UgoesSky/UgoesSky-V3.0b-PITS-Hardware/Bilder/1.jpg

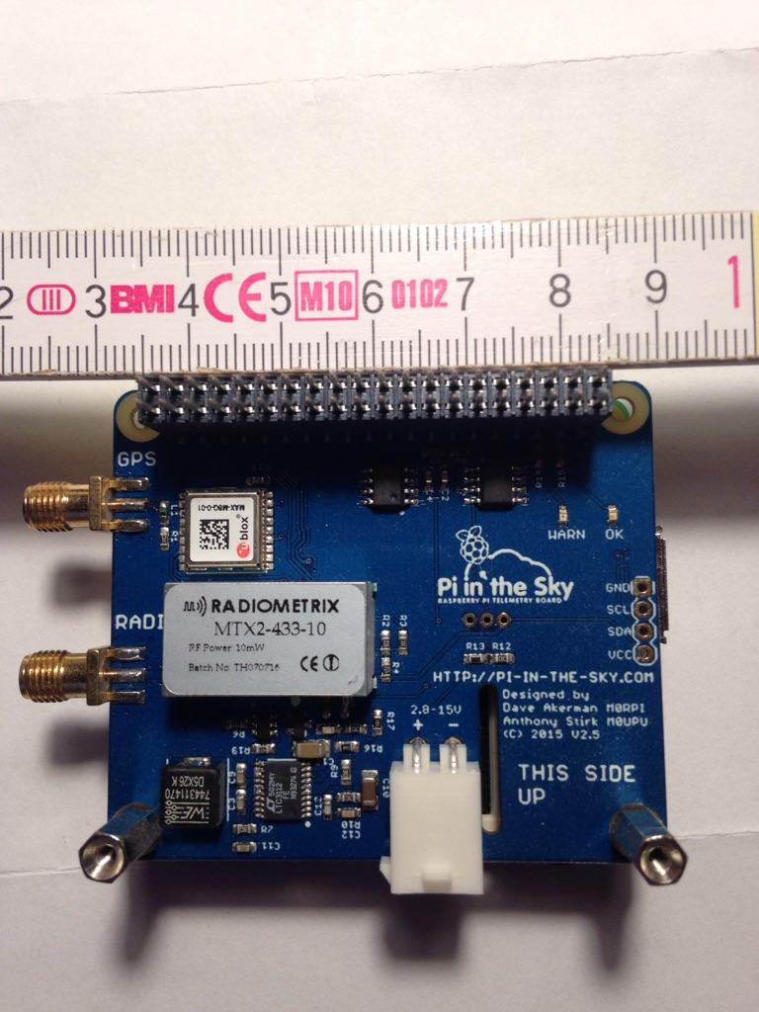
Bilder/1.jpg
