UgoesSky/UgoesSky-V3.0b-PITS-Hardware/Bilder/4.jpg

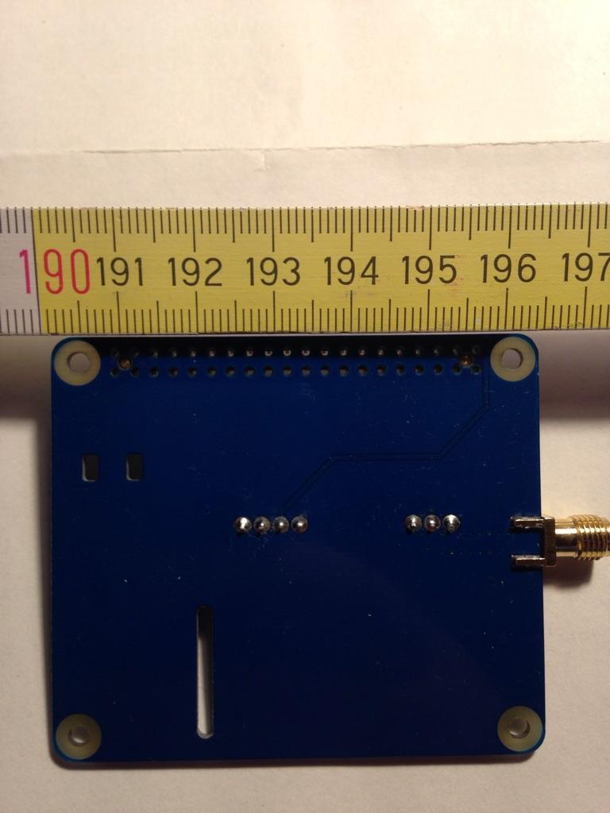
Bilder/4.jpg
