UgoesSky/UgoesSky-V3.0b-PITS-Hardware/README.md

# UgoesSky-V3.0b-PITS-Hardware
https://github.com/PiInTheSky/pits-hardware
