UgoesSky/UgoesSky-V3.0b-PITS-Hardware/Bilder/2.jpg

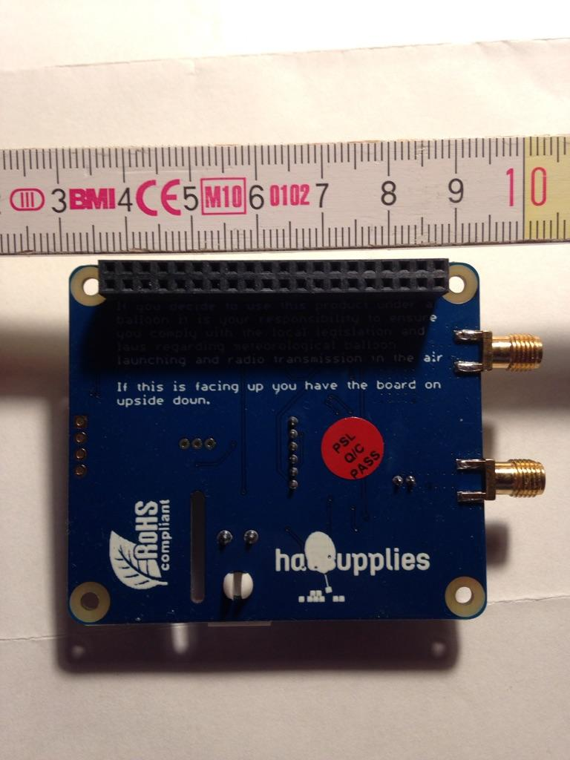
Bilder/2.jpg
