UgoesSky/UgoesSky-V3.0b-PITS-Hardware/Bilder/3.jpg

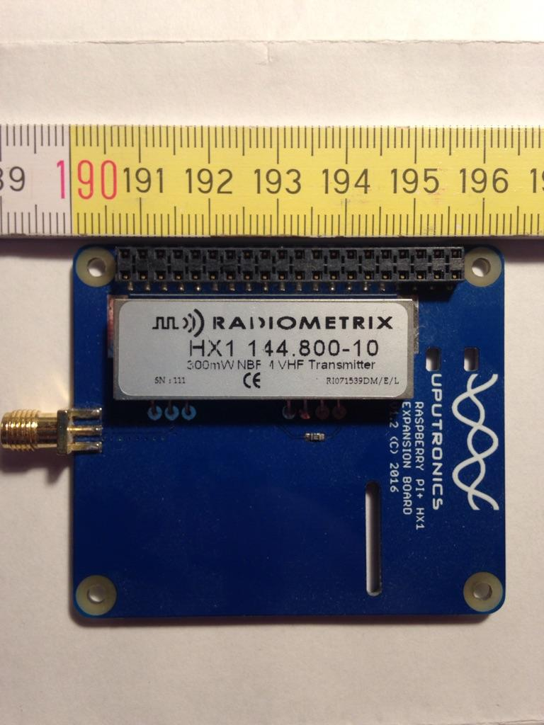
Bilder/3.jpg
