UgoesSky/UgoesSky-V3.0b-PITS-Hardware/Bilder/aprs.jpg

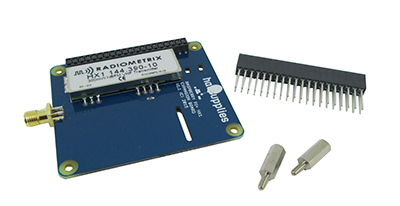
Bilder/aprs.jpg
