UgoesSky/UgoesSky-V3.0b-PITS-Hardware/Bilder/lora.jpg

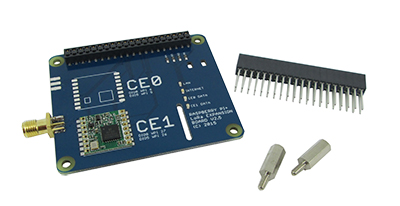
Bilder/lora.jpg
