UgoesSky/UgoesSky-V3.0b-PITS-Hardware/Bilder/mainboard.jpg

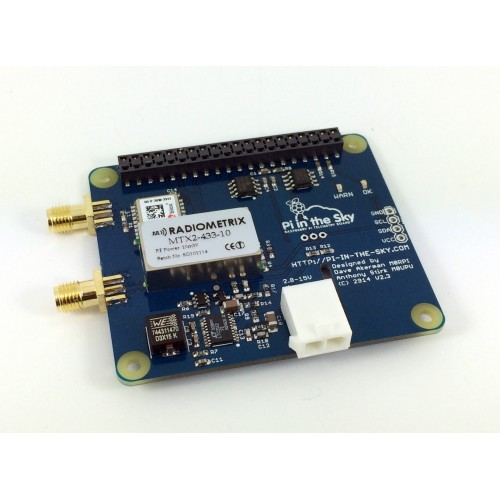
Bilder/mainboard.jpg
