UgoesSky/UgoesSky-V3.0b-PITS-Hardware/Bilder/Matek/1.jpg

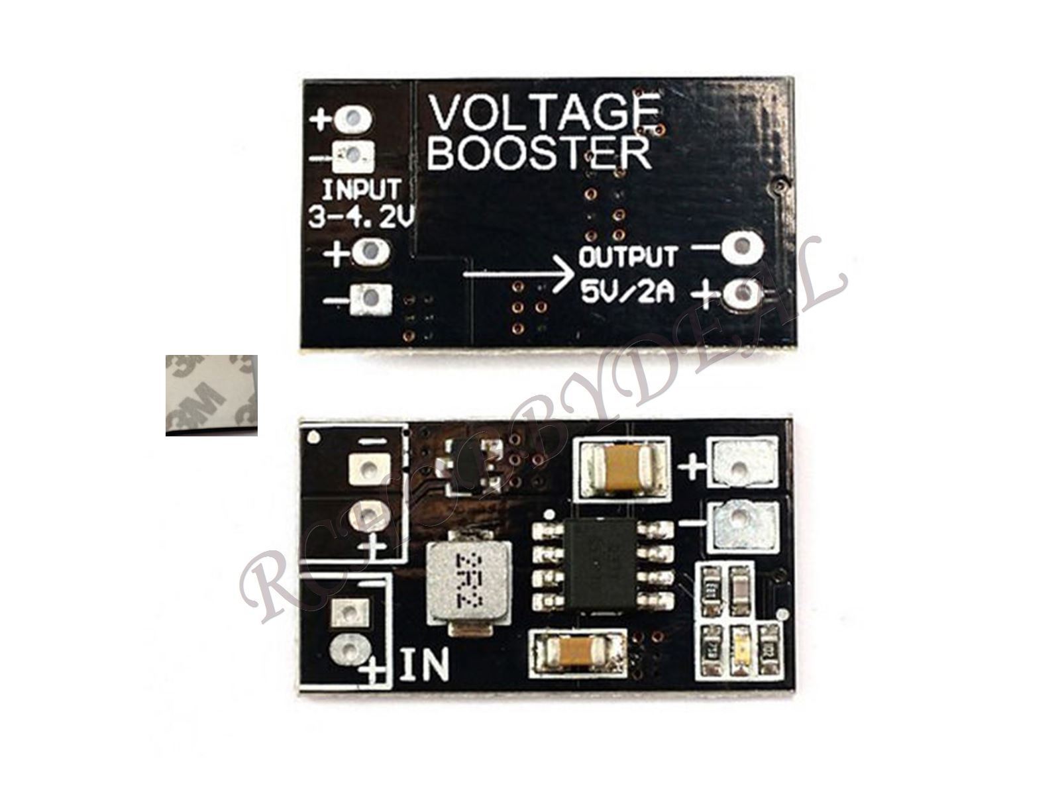
Bilder/Matek/1.jpg
