UgoesSky/UgoesSky-V3.0b-PITS-Hardware/Bilder/Matek/2.jpg

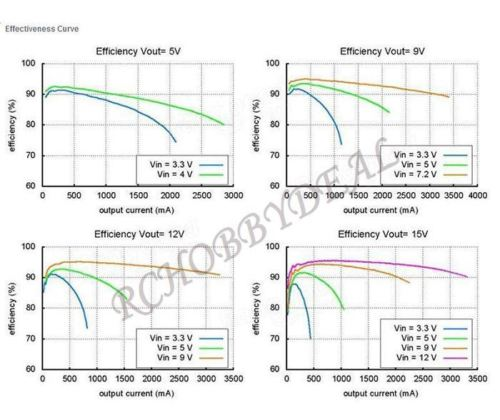
Bilder/Matek/2.jpg
