UgoesSky/UgoesSky-V3.0b-PITS-Hardware/Bilder/Matek/3.jpg

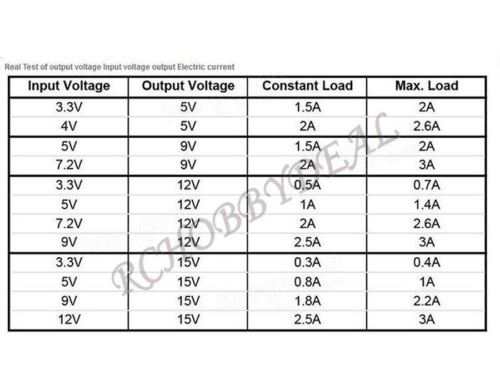
Bilder/Matek/3.jpg
