UgoesSky/UgoesSky-V3.0b-PITS-Hardware/Bilder/Matek/4.jpg

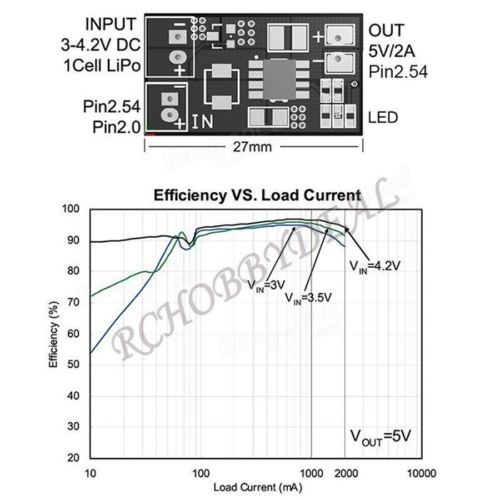
Bilder/Matek/4.jpg
