UgoesSky/UgoesSky-V3.0b-PITS-Hardware/Bilder/Matek/5.jpg

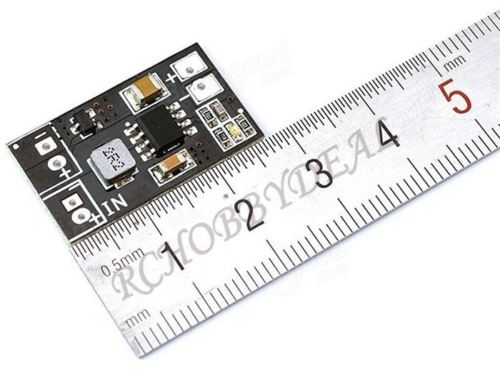
Bilder/Matek/5.jpg
