UgoesSky/UgoesSky-V3.0b-PITS-Hardware/Bilder/pitszero.jpg

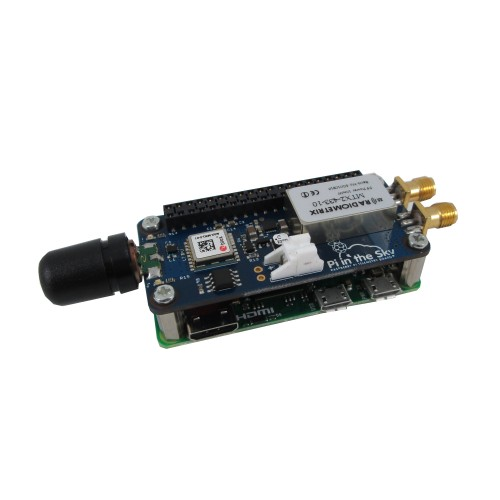
Bilder/pitszero.jpg
