UgoesSky/UgoesSky-V3.0b-PITS-Hardware/Bilder/TPS61030/3.jpg

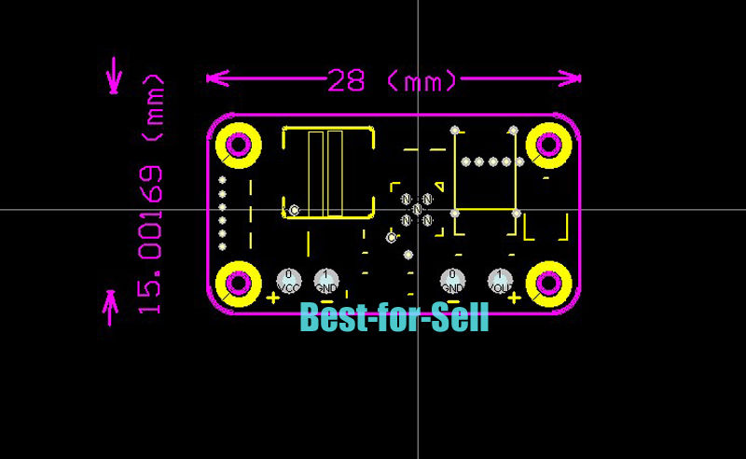
Bilder/TPS61030/3.jpg
