UgoesSky/UgoesSky-V3.0b-PITS-Hardware/Bilder/TPS61030/3b.jpg

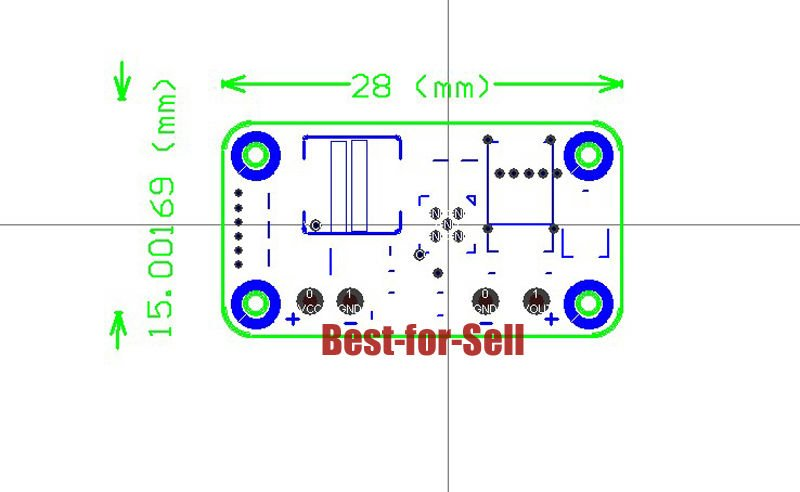
Bilder/TPS61030/3b.jpg
