UgoesSky/UgoesSky-V3.0b-PITS-Hardware/PITS/BOTTOM.png

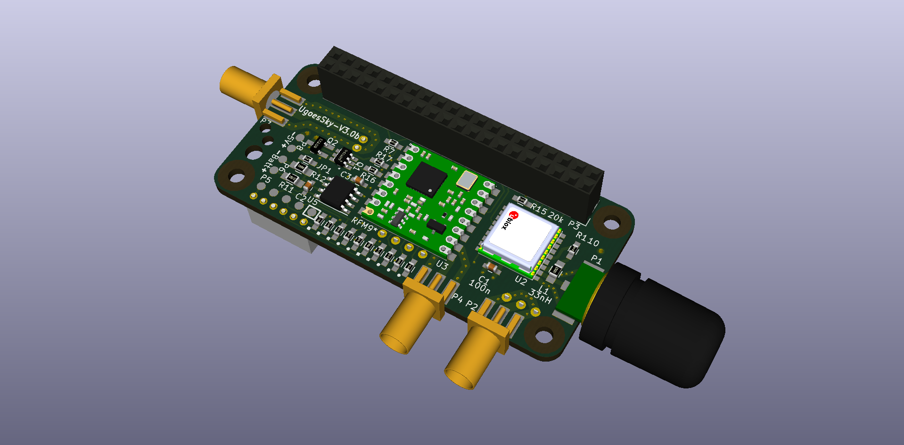
PITS/BOTTOM.png
