UgoesSky/UgoesSky-V3.0b-PITS-Hardware/PITS/TOP.png

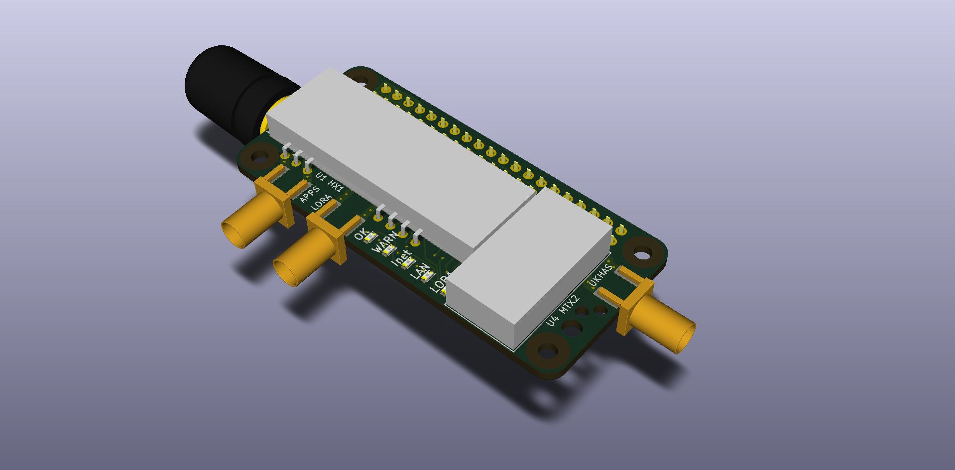
PITS/TOP.png
