UgoesSky/UgoesSky-V3.0b-PITS-Hardware/BOM.ods

Sheet: PITS
Id | Designator | Package | Quantity | Designation | Notes | Supplier | Ref | Supplier | Ref | Status
1 | R10,R8,R14,R13,R9 | R_0603_HandSoldering | 5 | 4k7 |  |  |  |  |  | vorhanden
2 | U4 | MTX2 | 1 | MTX2 |  | uputronics | HAB-MTX2 |  |  | vorhanden
3 | R6,R2,R3,R4,R5 | R_0603_HandSoldering | 5 | 330 |  |  |  |  |  | vorhanden
4 | P3 | Socket_Strip_Straight_2x20 | 1 | GPIO |  |  |  | TME | ZL262-40DG | vorhanden
5 | REF**,REF**,REF**,REF** | MountingHole_2.75mm | 4 | MountingHole_2.75mm |  |  |  |  |  | kein Teil
6 | L1 | R_0805_HandSoldering | 1 | 33nH |  |  |  |  |  | nicht Notwendig
7 | Q2 | SOT-23_Handsoldering | 1 | DMP1045U |  | Mouser | 621-DMP1045U-7 | TME | DMP1045U-7 | vorhanden
8 | U5 | SOIC-8_3.9x4.9mm_Pitch1.27mm | 1 | MCP3426 |  | Mouser | 579-MCP3426A0E/MS | conrad | 1083143 – 62 | zu bestellen
9 | U2 | MAX-M8 | 1 | MAX-M8Q |  | uputronics |  | TME | MAX-M8Q | vorhanden
10 | U3 | RFM9xW | 2 | RFM95 |  | uputronics | HAB-RFM95W-868S2 |  |  | vorhanden
11 | C3,C1,C2 | C_0603_HandSoldering | 3 | 100n |  |  |  |  |  | vorhanden
12 | D1 | LED_0603 | 1 | OK_Green |  |  |  | TME | LGL29K-G2J1-24 | vorhanden
13 | D2 | LED_0603 | 1 | WARN_Red |  |  |  | TME | TLMO1000-GS08 | vorhanden
14 | D3 | LED_0603 | 1 | Inet_Green |  |  |  | TME | LGL29K-G2J1-24 | vorhanden
15 | D4 | LED_0603 | 1 | LAN_Yellow |  |  |  | TME | LY-L29K-J1K2-26 | vorhanden
16 | D5 | LED_0603 | 1 | LORA_Red |  |  |  | TME | TLMO1000-GS08 | vorhanden
17 | R1 | R_0603_HandSoldering | 1 | 10 |  |  |  |  |  | nicht Notwendig
18 | R15,R7 | R_0603_HandSoldering | 2 | 20k |  |  |  |  |  | vorhanden
19 | R16 | R_0603_HandSoldering | 1 | 10k |  |  |  |  |  | vorhanden
20 | R17 | R_0603_HandSoldering | 1 | 47k |  |  |  |  |  | vorhanden
21 | Q1 | SOT-23-6_Handsoldering | 1 | DMMT5401 |  | Mouser | 621-DMMT5401-7-F | TME | DMMT5401-7-F | vorhanden
22 | P2 | SMA_Edge_small | 1 | APRS |  |  |  |  |  | vorhanden
23 | P7 | SMA_Edge_small | 1 | UKHAS |  |  |  |  |  | vorhanden
24 | P4 | SMA_Edge_small | 1 | LORA |  |  |  |  |  | vorhanden
25 | U1 | HX1_Horizontal | 1 | HX1 |  | uputronics | HAB-HX1-800 |  |  | vorhanden
26 | P1 | MWSL1252 | 1 | MWSL-1252 |  | uputronics | HAB-SL1252R |  |  | vorhanden
27 | JP1 | R_0603_HandSoldering | 1 | CH2- to GND |  |  |  |  |  | kein Teil
28 | R11 | R_0805_HandSoldering | 1 | 15k | 0,10% |  |  |  |  | vorhanden
29 | R12 | R_0805_HandSoldering | 1 | 10k | 0,10% |  |  |  |  | vorhanden
30 | P6 | SMD_2_xsmall | 1 | Batt |  |  |  |  |  | kein Teil
31 | P5 | SMD_5_xsmall | 1 | SENSOR |  |  |  |  |  | kein Teil
32 | P8 | SMD_2_xsmall | 1 | 5V |  |  |  |  |  | kein Teil
33 | REF** | Bohrung_3mm | 1 | Bohrung_3mm |  |  |  |  |  | kein Teil
34 | REF**,REF** | Bohrung_2mm | 2 | Bohrung_2mm |  |  |  |  |  | kein Teil
35 |  | Distanzhuelse L12 | 4 |  |  |  |  | TME | TFM-M2.5X12/DR282 | vorhanden
36 |  | Distanzhuelse L8 | 2 |  |  |  |  | TME | TFF-M2.5X8/DR182 | vorhanden
37 |  | Schraube | 6 |  |  |  |  | TME | DR8G206M2.5X04.5 | vorhanden
38 | M1 | BME280 | 1 | BME280 |  | ebay |  |  |  | vorhanden
39 | M2 | TPS61030 | 1 | TPS61030 |  |  |  |  |  | vorhanden
40 |  |  | 3 | SMA to RG174 Pigtail |  | uputronics | HAB-SMA-TAIL |  |  | vorhanden
41 |  | TO92 | 5 | DS18B20 |  |  |  | TME | DS18B20+ | vorhanden

Sheet: Tabelle2
ZL262-40DG | 1
DMP1045U-7 | 1
LGL29K-G2J1-24 | 1
TLMO1000-GS08 | 1
LGL29K-G2J1-24 | 1
LY-L29K-J1K2-26 | 1
TLMO1000-GS08 | 1
DMMT5401-7-F | 1
TFM-M2.5X12/DR282 | 4
TFF-M2.5X8/DR182 | 2
DR8G206M2.5X04.5 | 6
DS18B20+ | 5
