UgoesSky/UgoesSky-V3.0b-PITS-Hardware/Masse.ods

Bauteil | Gewicht | Anzahl | Gesamtgewicht
Pi | 23 | 1 | 23
Platine | 15 | 1 | 15
APRS/HX1 | 4 | 1 | 4
UKHAS/MTX2 | 4 | 1 | 4
LORA 1 | 5 | 1 | 5
LORA 2 | 5 | 1 | 5
PiCam | 4 | 1 | 4
Batterie |  |  | 0
Antenne LORA 1 |  |  | 0
Antenne LORA 2 |  |  | 0
Antenne APRS/HX1 |  |  | 0
Antenne UKHAS/MTX2 |  |  | 0
Antenne GPS/ublox |  |  | 0
Styropor |  |  | 0
Steckverbinder Antennen | 2 | 5 | 10
Sonstiges |  |  | 10
Summe |  |  | 80
