UgoesSky/UgoesSky-V3.0b-PITS-Hardware/3D Modelle/BME280_edit.fcstd

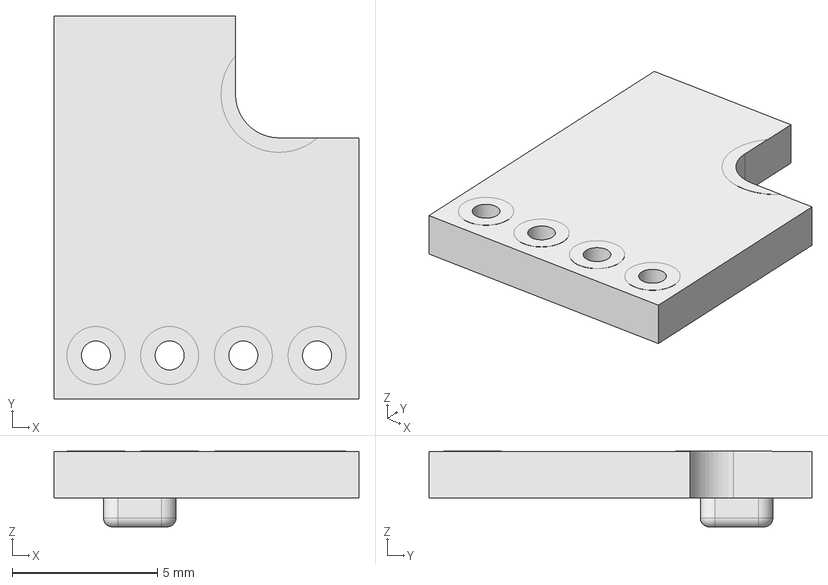
[picture p22: CAD file, 2018-01-22]
3D Modelle/BME280_edit.fcstd
10.5 x 13.2 x 2.61 mm
