UgoesSky/UgoesSky-V3.0b-PITS-Hardware/3D Modelle/BME280.fcstd

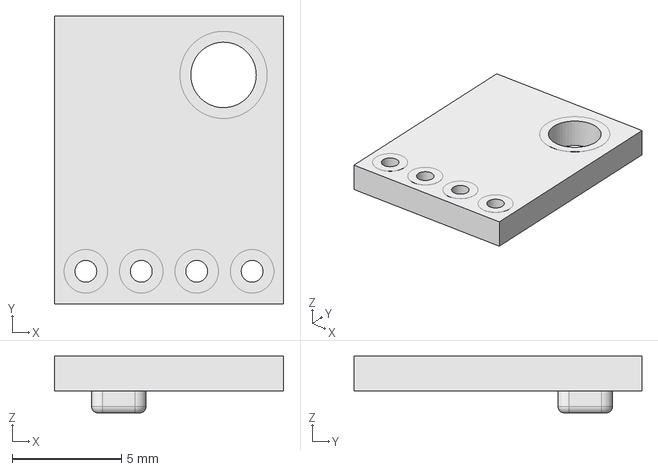
[picture p23: CAD file, 2018-01-21]
3D Modelle/BME280.fcstd
10.5 x 13.2 x 2.61 mm
