UgoesSky/UgoesSky-V3.0b-PITS-Hardware/3D Modelle/MWSL1252.fcstd

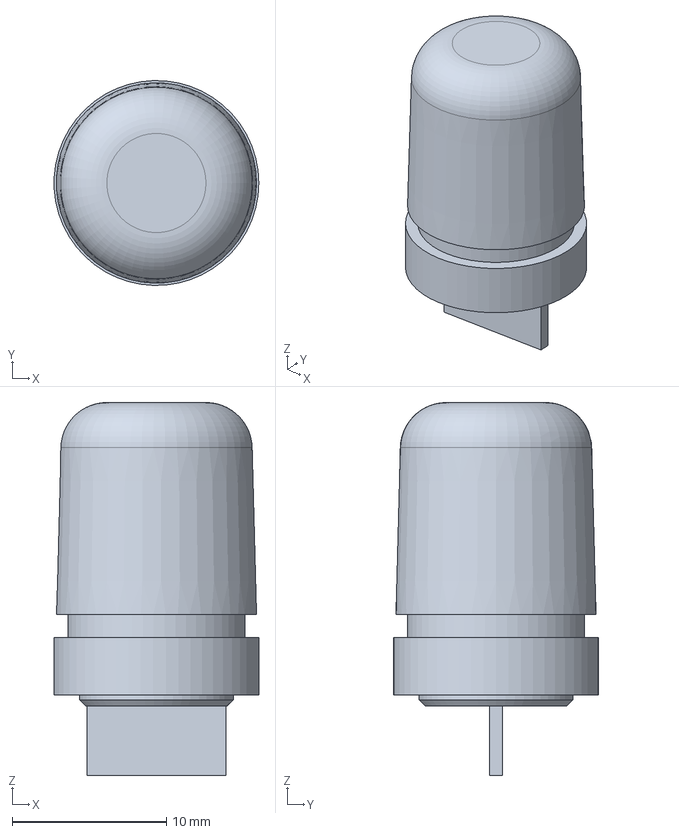
[picture p24: CAD file, 2017-08-15]
3D Modelle/MWSL1252.fcstd
13.3 x 13.3 x 24.2 mm
