UgoesSky/UgoesSky-V3.0b-PITS-Hardware/3D Modelle/HX1.fcstd

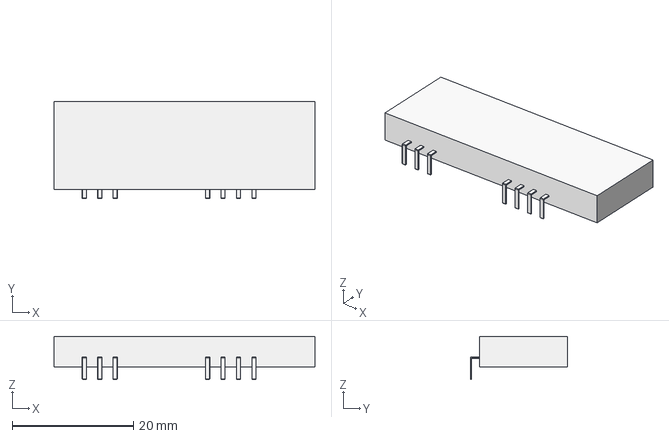
[picture p25: CAD file, 2017-08-12]
3D Modelle/HX1.fcstd
43.0 x 16.0 x 7.10 mm
