UgoesSky/UgoesSky-V3.0b-PITS-Hardware/3D Modelle/SMA.fcstd

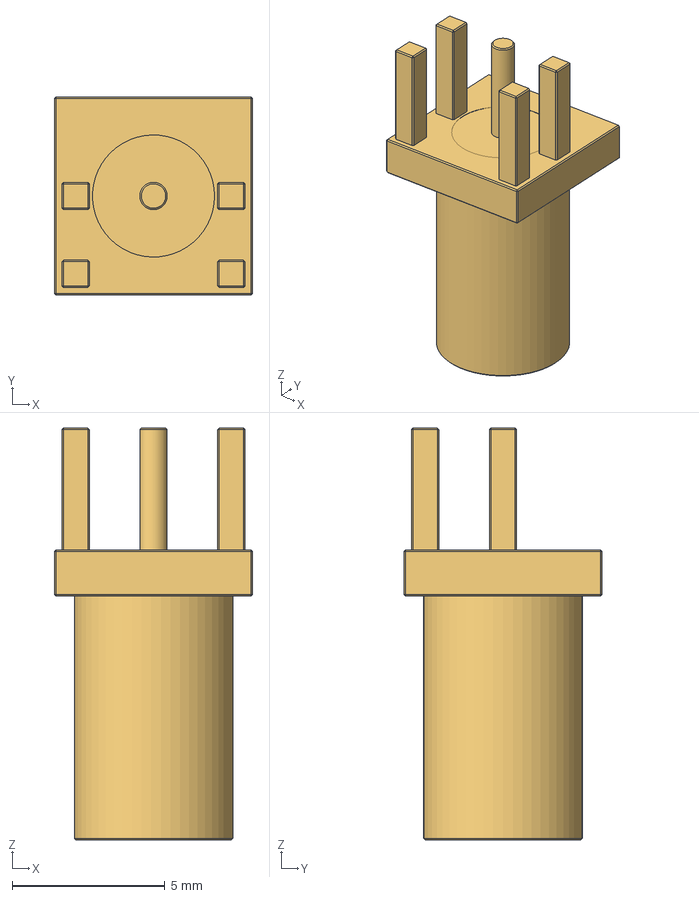
[picture p26: CAD file, 2017-08-11]
3D Modelle/SMA.fcstd
6.50 x 6.50 x 13.5 mm
