UgoesSky/UgoesSky-V3.0b-PITS-Hardware/3D Modelle/TPS61030.fcstd

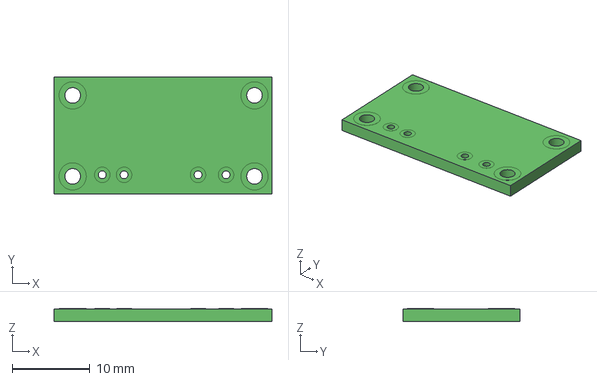
[picture p27: CAD file, 2017-08-12]
3D Modelle/TPS61030.fcstd
28.0 x 15.0 x 1.61 mm
