UgoesSky/UgoesSky-V3.0b-PITS-Hardware/(list of files, cad)

Other CAD files:
3D Modelle/SMA.stl
