UgoesSky/UgoesSky-V3.0b-PITS-Hardware/PITS/Platine.pdf

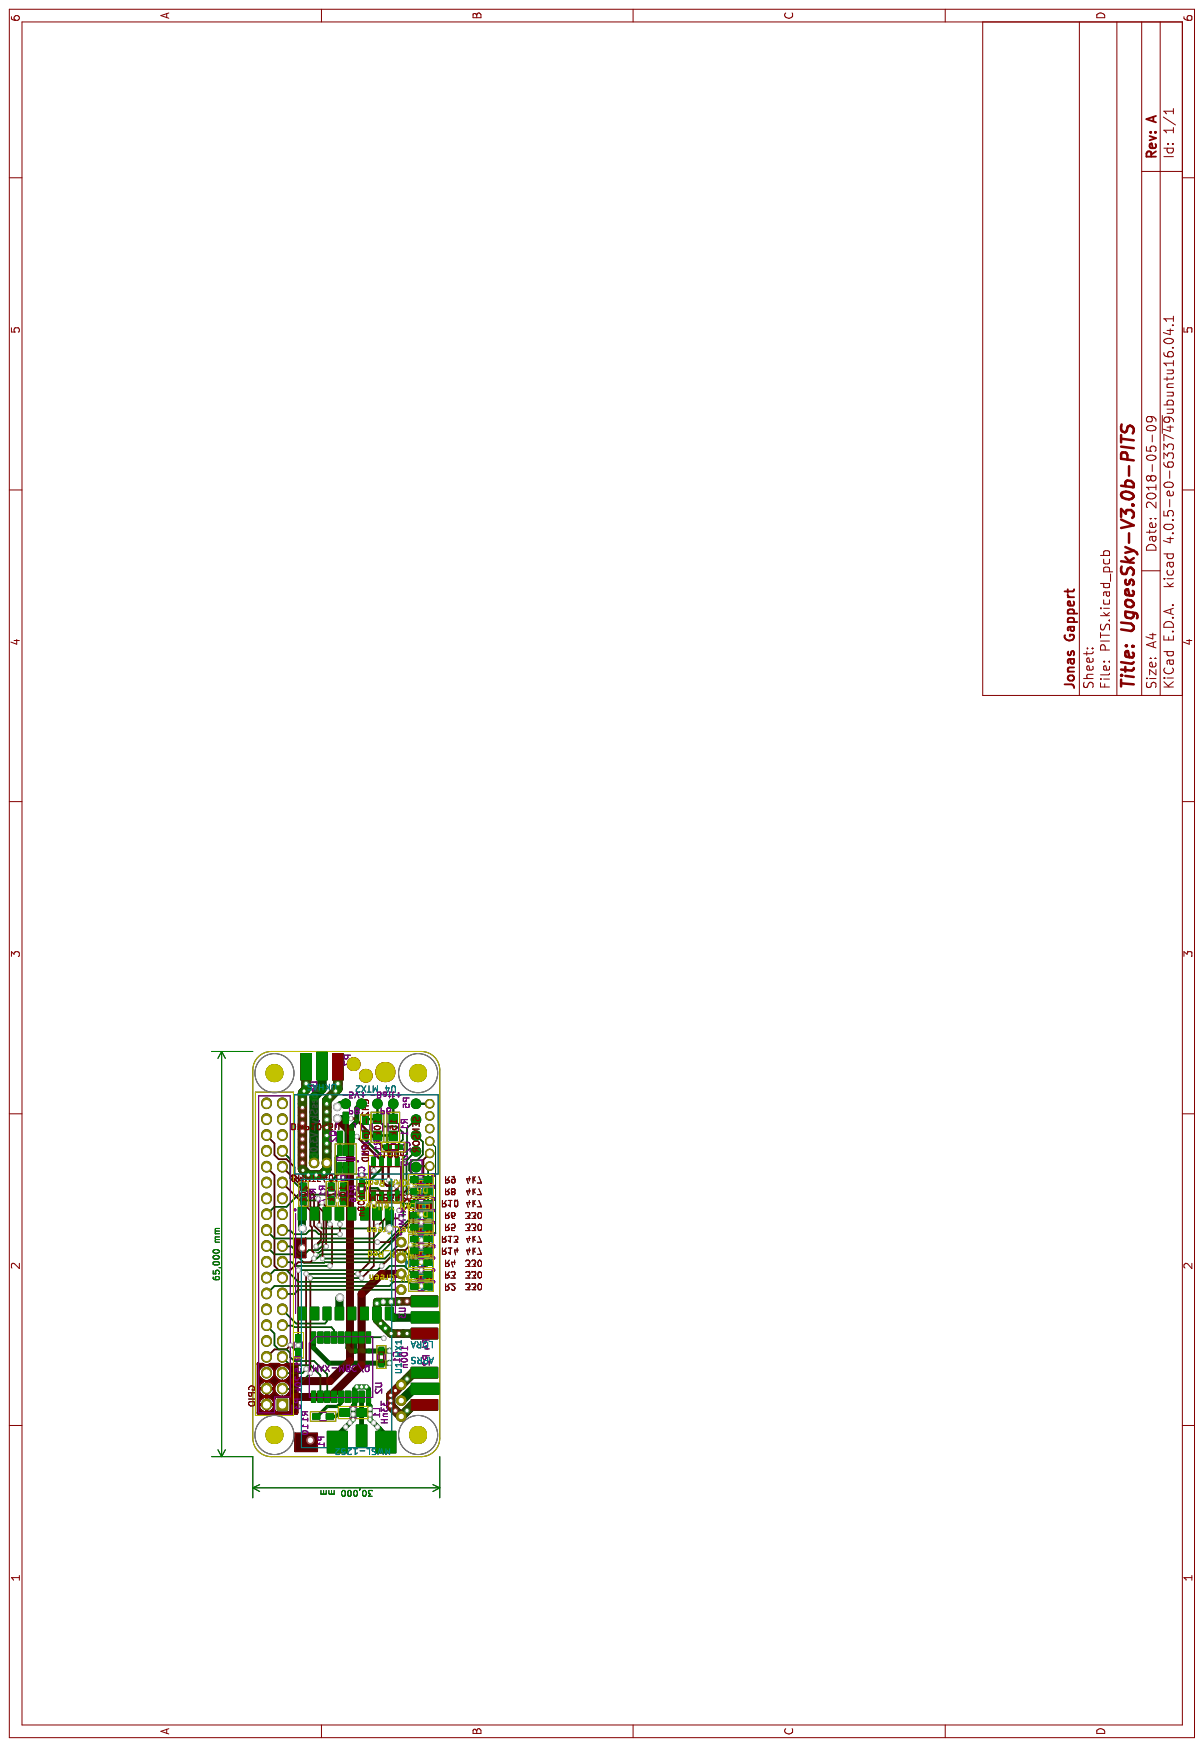
[picture p28: page 1]
