UgoesSky/UgoesSky-V3.0b-PITS-Hardware/PITS/Schaltplan.pdf

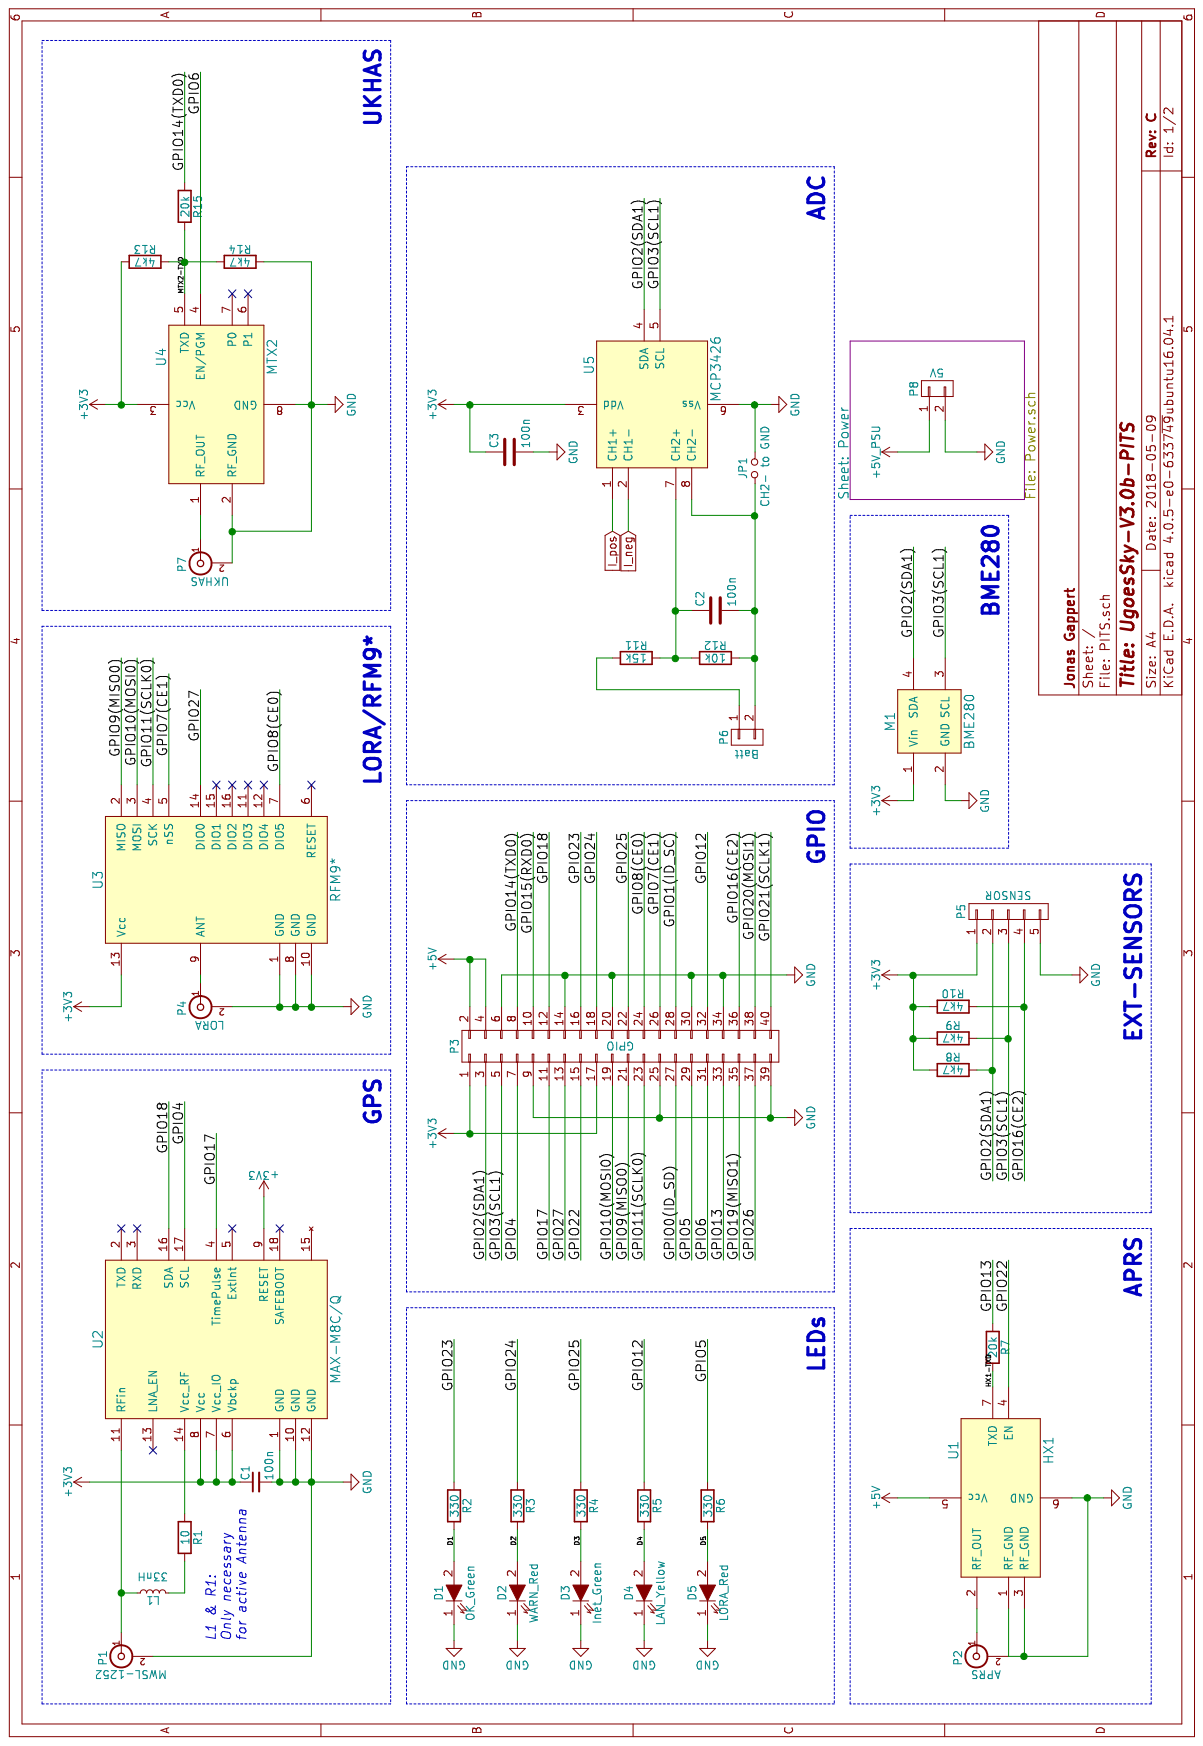
[picture p29: page 1]

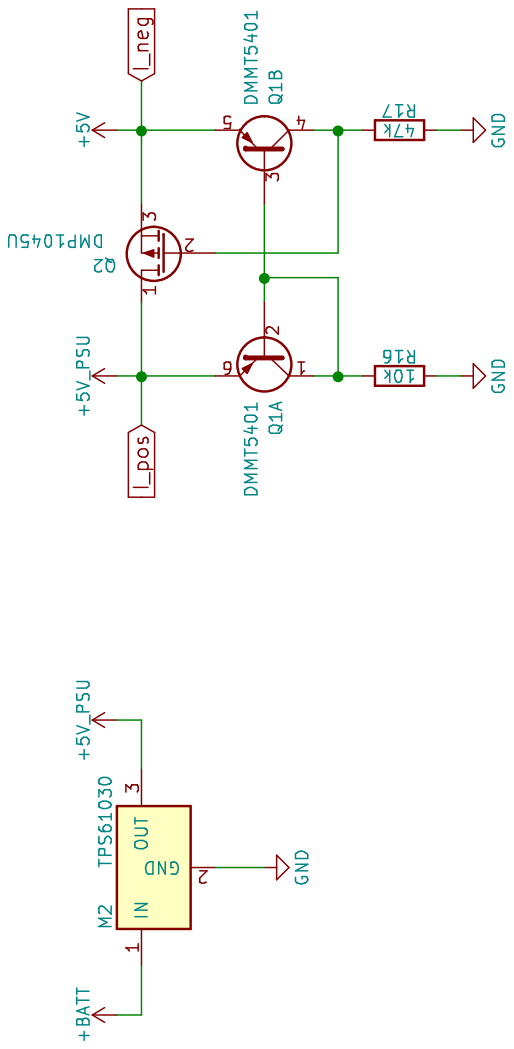
[picture p30: page 2]
