UgoesSky/UgoesSky-V3.0b-PITS-Hardware/PITS/PITS.kicad_pcb

## KiCad design PITS/PITS.kicad_pcb (2018-05-09)

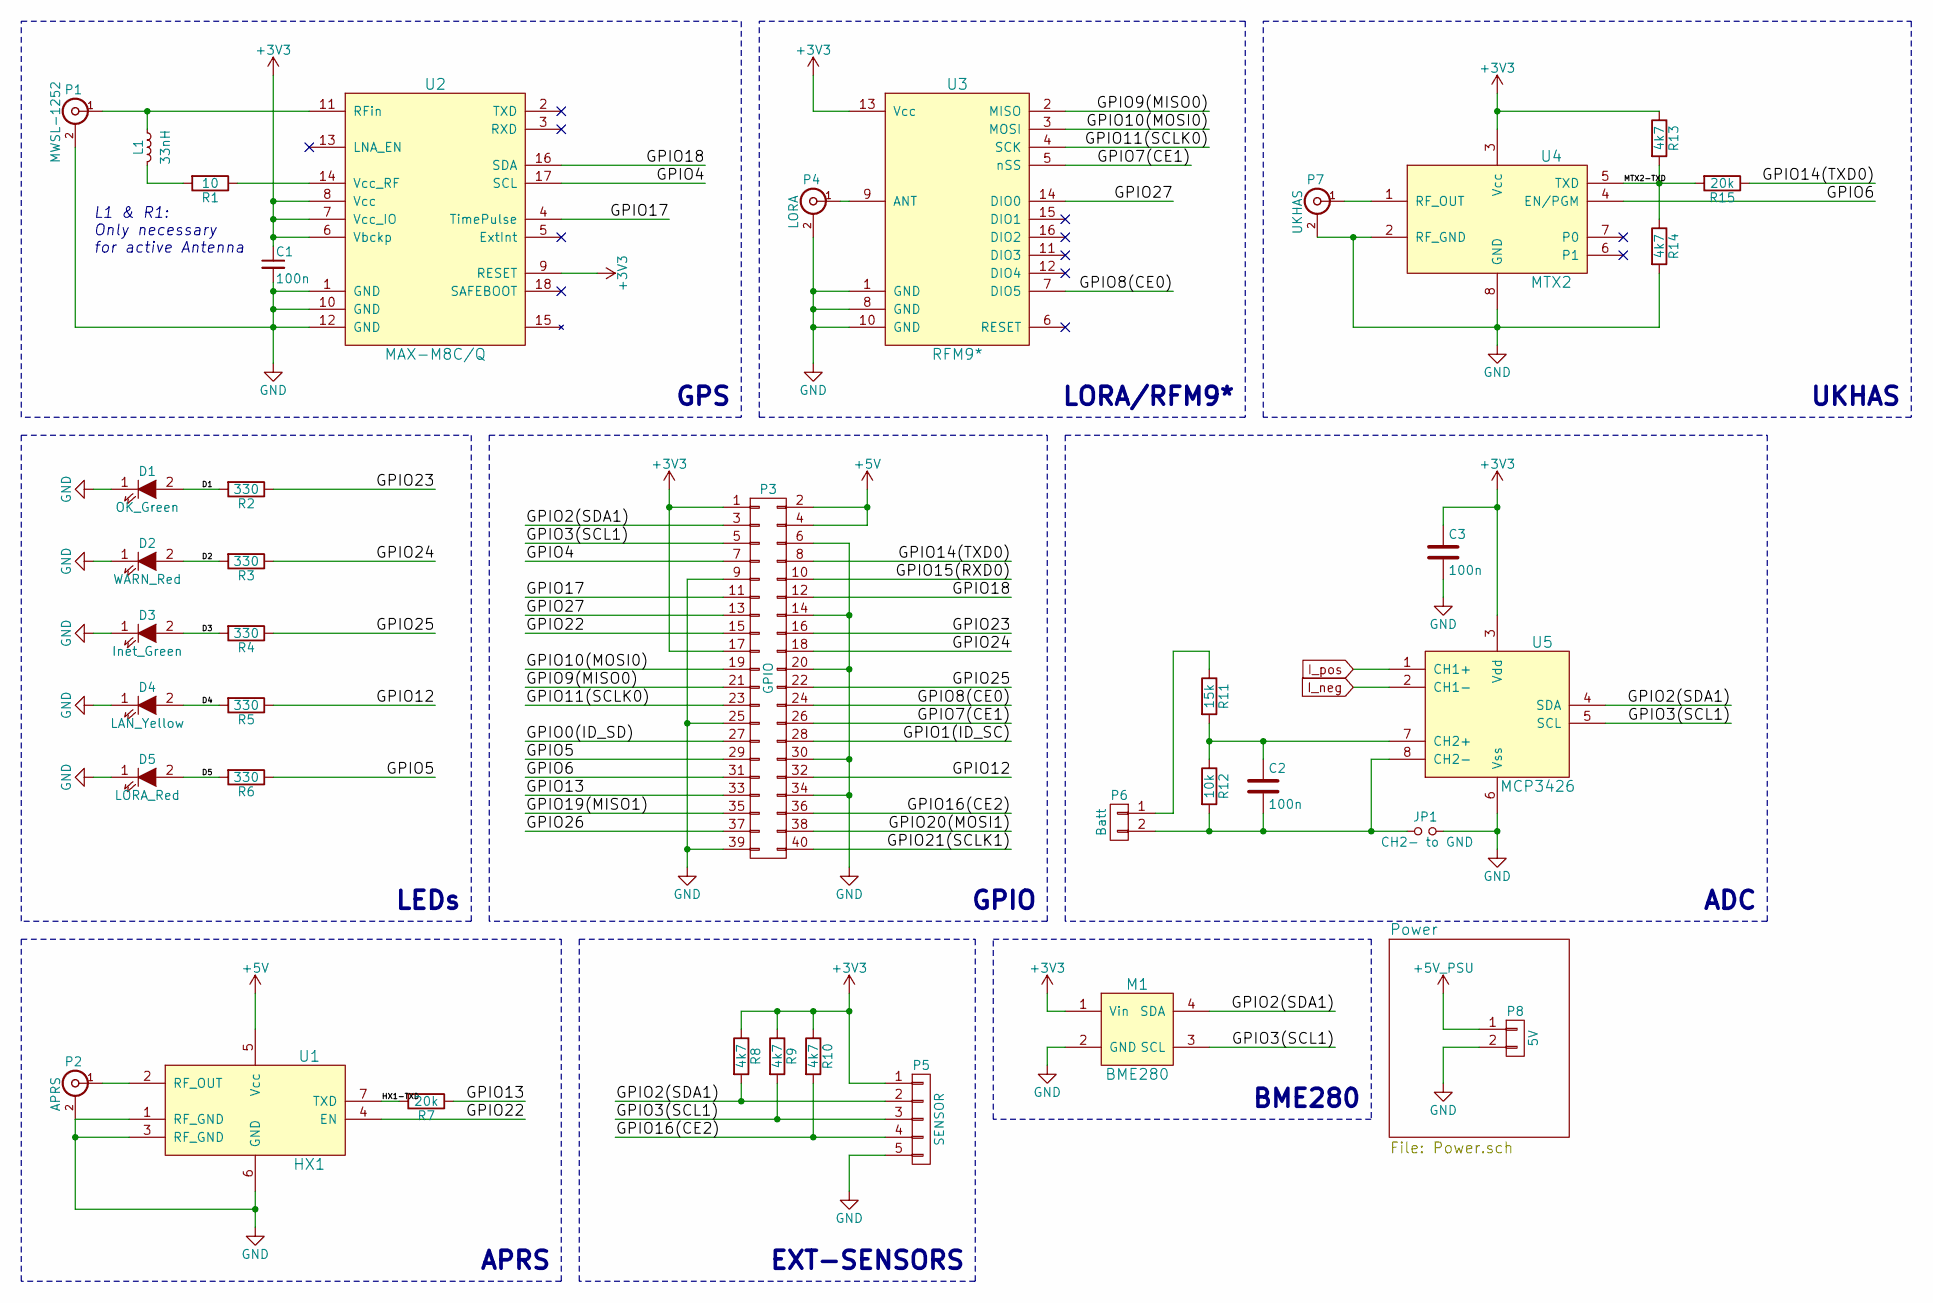
[picture p31: schematic PITS.sch, UgoesSky-V3.0b-PITS]

Parts:
C1, C2, C3: 100n; C_0603_HandSoldering
D1: OK_Green; LED_0603
D2: WARN_Red; LED_0603
D3: Inet_Green; LED_0603
D4: LAN_Yellow; LED_0603
D5: LORA_Red; LED_0603
JP1: CH2- to GND; R_0603_HandSoldering
L1: 33nH; R_0805_HandSoldering
M1: BME280
P1: MWSL-1252; MWSL1252
P2: APRS; SMA_Edge_small
P3: GPIO; Socket_Strip_Straight_2x20
P4: LORA; SMA_Edge_small
P5: SENSOR; SMD_5_xsmall
P6: Batt; SMD_2_xsmall
P7: UKHAS; SMA_Edge_small
P8: 5V; SMD_2_xsmall
R1: 10; R_0603_HandSoldering
R2, R3, R4, R5, R6: 330; R_0603_HandSoldering
R7, R15: 20k; R_0603_HandSoldering
R8, R9, R10, R13, R14: 4k7; R_0603_HandSoldering
R11: 15k; R_0805_HandSoldering
R12: 10k; R_0805_HandSoldering
U1: HX1; HX1_Horizontal
U2: MAX-M8C/Q; MAX-M8
U3: RFM9*; RFM9xW
U4: MTX2
U5: MCP3426; SOIC-8_3.9x4.9mm_Pitch1.27mm

Connections:
+3V3: C1.1, C3.1, M1.1 (Vin), P3.1, P3.17, P5.1, R8.1, R9.1, R10.1, R13.1, U2.6 (Vbckp), U2.7 (Vcc_IO), U2.8 (Vcc), U2.9 (RESET), U3.13 (Vcc), U4.3 (Vcc), U5.3 (Vdd)
/D1: D1.2 (A), R2.2
/D2: D2.2 (A), R3.2
/D3: D3.2 (A), R4.2
/D4: D4.2 (A), R5.2
/D5: D5.2 (A), R6.2
/GPIO0(ID_SD): P3.27
/GPIO1(ID_SC): P3.28
/GPIO2(SDA1): M1.4 (SDA), P3.3, P5.2, R8.2, U5.4 (SDA)
/GPIO3(SCL1): M1.3 (SCL), P3.5, P5.3, R9.2, U5.5 (SCL)
/GPIO4: P3.7, U2.17 (SCL)
/GPIO5: P3.29, R6.1
/GPIO6: P3.31, U4.4 (EN/PGM)
/GPIO7(CE1): P3.26, U3.5 (nSS)
/GPIO8(CE0): P3.24, U3.7 (DIO5)
/GPIO9(MISO0): P3.21, U3.2 (MISO)
/GPIO10(MOSI0): P3.19, U3.3 (MOSI)
/GPIO11(SCLK0): P3.23, U3.4 (SCK)
/GPIO12: P3.32, R5.1
/GPIO13: P3.33, R7.1
/GPIO14(TXD0): P3.8, R15.1
/GPIO15(RXD0): P3.10
/GPIO16(CE2): P3.36, P5.4, R10.2
/GPIO17: P3.11, U2.4 (TimePulse)
/GPIO18: P3.12, U2.16 (SDA)
/GPIO19(MISO1): P3.35
/GPIO20(MOSI1): P3.38
/GPIO21(SCLK1): P3.40
/GPIO22: P3.15, U1.4 (EN)
/GPIO23: P3.16, R2.1
/GPIO24: P3.18, R3.1
/GPIO25: P3.22, R4.1
/GPIO26: P3.37
/GPIO27: P3.13, U3.14 (DIO0)
/HX1-TXD: R7.2, U1.7 (TXD)
/MTX2-TXD: R13.2, R14.1, R15.2, U4.5 (TXD)
GND: C1.2, C3.2, D1.1 (K), D2.1 (K), D3.1 (K), D4.1 (K), D5.1 (K), JP1.2, M1.2 (GND), P1.2 (Ext), P2.2 (Ext), P3.6, P3.9, P3.14, P3.20, P3.25, P3.30, P3.34, P3.39, P4.2 (Ext), P5.5, P7.2 (Ext), P8.2, R14.2, U1.1 (RF_GND), U1.3 (RF_GND), U1.6 (GND), U2.1 (GND), U2.10 (GND), U2.12 (GND), U3.1 (GND), U3.8 (GND), U3.10 (GND), U4.2 (RF_GND), U4.8 (GND), U5.6 (Vss); also elsewhere on the board
I_neg: P3.2, P3.4, U1.5 (Vcc), U5.2 (CH1-); also elsewhere on the board
I_pos: P8.1, U5.1 (CH1+); also elsewhere on the board
unnamed: C2.1, R11.2, R12.1, U5.7 (CH2+)
unnamed: C2.2, JP1.1, P6.2, R12.2, U5.8 (CH2-)
unnamed: L1.1, P1.1 (In), U2.11 (RFin)
unnamed: L1.2, R1.2
unnamed: P2.1 (In), U1.2 (RF_OUT)
unnamed: P4.1 (In), U3.9 (ANT)
unnamed: P6.1, R11.1
unnamed: P7.1 (In), U4.1 (RF_OUT)
unnamed: R1.1, U2.14 (Vcc_RF)

Notes on the sheet:
LEDs
ADC
GPIO
LORA/RFM9*
UKHAS
APRS
GPS
EXT-SENSORS
BME280
L1 & R1: Only necessary for active Antenna

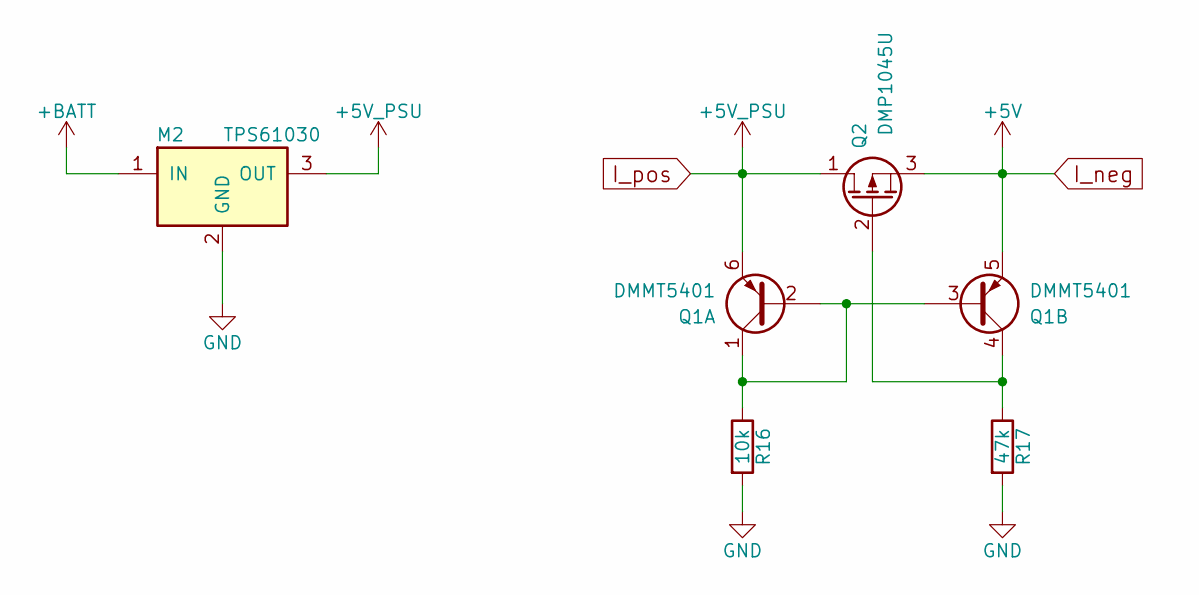
[picture p32: schematic Power.sch, UgoesSky-V3.0b-PITS]

Parts:
M2: TPS61030
Q1: DMMT5401; SOT-23-6_Handsoldering
Q2: DMP1045U; SOT-23_Handsoldering
R16: 10k; R_0603_HandSoldering
R17: 47k; R_0603_HandSoldering

Connections:
GND: M2.2 (GND), R16.2, R17.2; also elsewhere on the board
I_neg: Q1.5 (E), Q2.3 (S); also elsewhere on the board
I_pos: M2.3 (OUT), Q1.6 (E), Q2.1 (D); also elsewhere on the board
unnamed: Q1.1 (C), Q1.2 (B), Q1.3 (B), R16.1
unnamed: Q1.4 (C), Q2.2 (G), R17.1

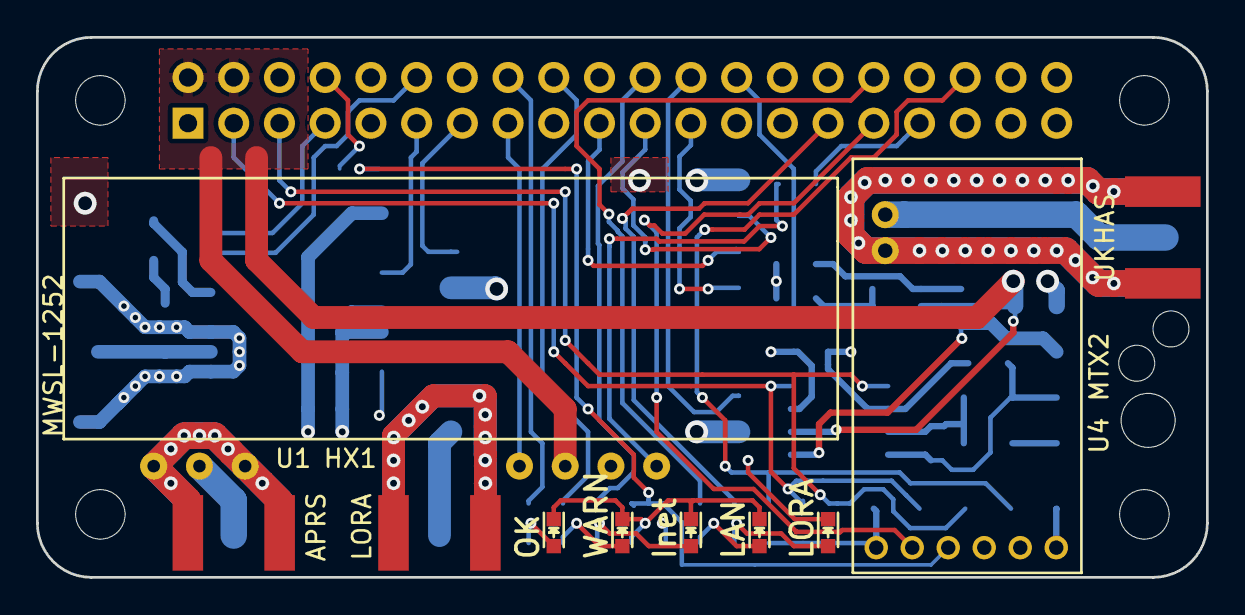
[picture p33: board PITS.kicad_pcb from above]

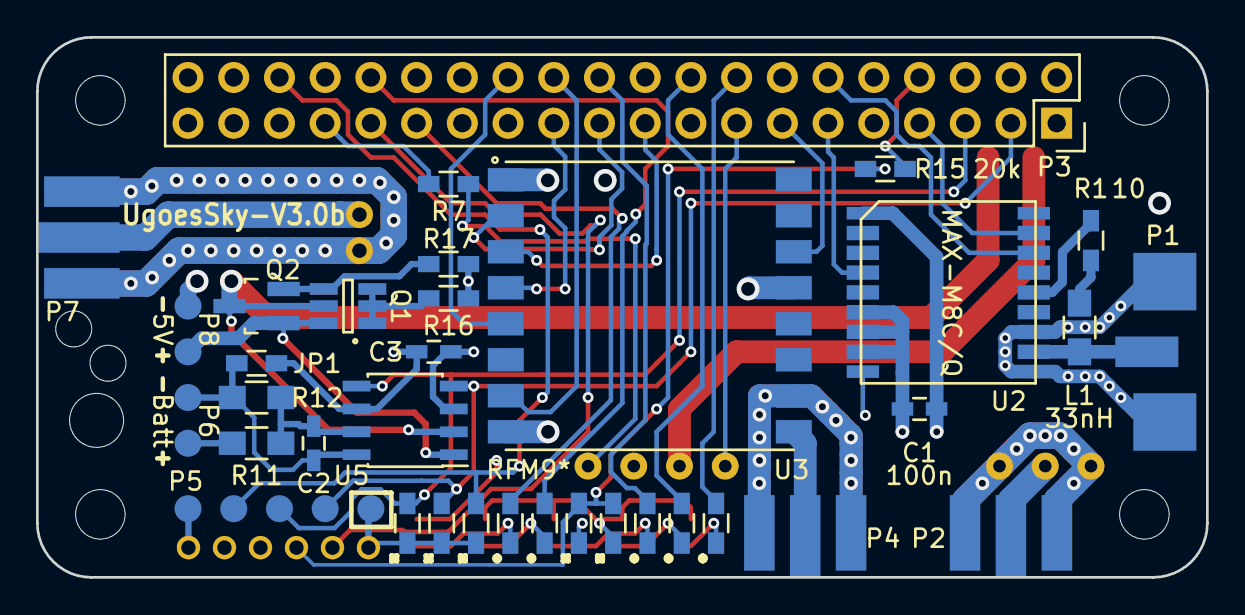
[picture p34: board PITS.kicad_pcb from below]

Board: 4 copper layers, 65.0 x 30.0 mm, 42 parts (35 on the bottom side), 43 nets.
