UgoesSky/UgoesSky-V3.0b-PITS-Hardware/(commit log)

2016-11-03 board - not finished
    [PITS.sch, Power.sch]
2017-01-04 first finished layout
    [PITS.kicad_pcb, PITS.sch, Power.sch]
2017-08-09 old layout - commit for backup
    [PITS.csv, PITS.kicad_pcb, PITS.sch]
2017-08-09 some files
    [Masse.ods, Pinbelegung.ods]
2017-08-09 working on layout
    [PITS.kicad_pcb, PITS.sch]
2017-08-11 SMA 3D
    [SMA.fcstd]
2017-08-11 layout - work in progress
    [PITS.kicad_pcb, PITS.sch]
2017-08-12 3D HX1
    [HX1.fcstd]
2017-08-12 3D TPS61030
    [TPS61030.fcstd, TPS61030.stl]
2017-08-12 layout for zero - work in progress - backup before pin header change
    [PITS.kicad_pcb, PITS.sch, Power.sch]
2017-08-12 layout - work in progress - first placement
    [PITS.kicad_pcb]
2017-08-13 layout - work in progress - power net
    [PITS.kicad_pcb, PITS.sch]
2017-08-14 layout - work in progress - first digital nets
    [PITS.kicad_pcb, PITS.sch]
2017-08-15 3D MWSL1252
    [MWSL1252.fcstd]
2017-08-15 layout - work in progress - backup GPS antenne change
    [PITS.kicad_pcb, PITS.sch]
2017-08-15 3D MWSL1252 add colours
    [MWSL1252.fcstd]
2017-08-16 layout - work in progress - RFM, LEDs, UBLOX
    [PITS.kicad_pcb, PITS.sch]
2017-08-20 neue Pinbelegung
    [PITS.kicad_pcb, PITS.sch, Pinbelegung.ods, Pinbelegung_Vorlage.ods]
2017-08-21 Layout - MTX2, HX1 and LEDs
    [PITS.kicad_pcb, PITS.sch, Pinbelegung.ods]
2017-08-21 ADC, BME280 and power switch
    [PITS.kicad_pcb, PITS.sch, Pinbelegung.ods, Power.sch]
2017-10-28 Layout almost finished
    [PITS.kicad_pcb, PITS.sch, Power.sch]
2017-10-28 3D BME280
    [BME280.fcstd]
2017-10-28 Checkt and updated
    [Pinbelegung.ods]
2017-10-28 Cleand up plan
    [PITS.sch, Power.sch]
2017-11-16 Fix #5
    [PITS.sch]
2017-11-16 Fix #6
    [PITS.sch]
2017-11-16 Fix #7
    [PITS.sch]
2017-11-16 Fix #8 & #9
    [PITS.sch, Power.sch]
2017-11-16 Fix #11
    [PITS.sch]
2017-11-16 Fix #12
    [PITS.sch]
2017-11-16 Added GND Jumper on CH2- of ADC
    [PITS.sch]
2017-11-16 updated Annotation
    [PITS.sch, Power.sch]
2017-11-16 export schematic
2018-01-16 Some cleanup
    [PITS.kicad_pcb, PITS.sch, Power.sch]
2018-01-16 update 3D model
    [TPS61030.stl]
2018-01-21 BME280 3D model
    [BME280.fcstd]
2018-01-22 PCB save
    [PITS.kicad_pcb]
2018-01-29 PCB save befor rerouting power lines
    [PITS.kicad_pcb]
2018-01-29 removed scound LORA led
    [PITS.kicad_pcb, PITS.sch, Pinbelegung.ods]
2018-04-14 all power routing done
    [PITS.kicad_pcb, PITS.sch]
2018-04-29 all routing finished!
    [PITS.kicad_pcb, PITS.sch]
2018-05-08 new Annotation and netlist
    [PITS.kicad_pcb, PITS.sch, Power.sch]
2018-05-08 fertiggit add Pinbelegung.ods !
    [PITS.csv, PITS.kicad_pcb, PITS.sch, Pinbelegung.ods, Power.sch]
2018-05-09 filled zones
    [PITS.kicad_pcb]
2018-08-21 some changes to save
    [PITS.csv]
